tjboldt/Apple2-IO-RPi/(notices)

Notices in the files:
Hardware/Apple2IORPi.kicad_pcb:
(c)2020-2024 Terence J. Boldt
